DC801/DC24PartyBadge/Hardware/AccessBadge_BOM_aa.xlsx

Mfg Part # | Ref. Des. | Description Value Pkg | QTY | DNI | NOTES
CL10A475KQ5LNNC | C1, C2 | CAPACITOR, 4.7uF, C0603 | 2
GRM033R60J104KE19D | C3, C4, C5 | CAPACITOR, 0.1uF, C0201 | 3
SML-D12V1WT86 | D1 | RED, LEDCHIP-LED0603 | 1
S2B-PH-SM4-TB(LF)(SN) | J1 | JST_2MM_MALE, JST-2-SMD, Mates to single-cell LiPo batteries | 1
10118192-0001LF | JP1 | USB_MICROB_PLUGCONN-11752, USB-B-MICRO-SMD_V03, USB Micro-B Plug | 1
3220-10-0300-00 | x1 | 10 Positions Header, Shrouded Connector 0.050" (1.27mm) Surface Mount Gold | 1 |  | Digikey # 1175-1629-ND
KXT 131 LHS | SLC | TACTILE_BUTTON, KXT131 | 1
RMCF0201JT2K00 | R4 | RESISTOR, 2.0k, R0201 | 1
RMCF0201JT470R | R5 | RESISTOR, 470, R0201 | 1
RC0201FR-07105RL | R1, R11 | RESISTOR, 105, R0201 | 2
RC0201JR-0743RL | R2, R3, R12, R20 | RESISTOR, 43, R0201 | 4
RMCF0201JT1K80 | R24, R25 | RESISTOR, 1.8k, R0201 | 2
RC0201JR-0739RL | R29 | RESISTOR, 39, R0201 | 1
JS102011SAQN | S1 | SWITCH-SPDTSMD2, SWITCH-SPDT-SMD, SPDT Switch | 1
 | SPARE_1 | MA03-1, PIN HEADER | 0 | DNI
LTST-C19HE1WT | U$1, U$9 | RGB, 606 | 2 |  | Lite-On
TPS73233DBVT | U2 | Cap-Free, NMOS, 250mA Low Dropout Regulator with Reverse Current Protection, SOT-23-5, SOT95P280X145-5N | 1 |  | Texas Instruments
MCP73831T-2ACI/OT | U3 | MCP73831, SOT23-5, Microchip's MCP73831 | 1
SML-P11DTT86 | U4, U5, U11, U12, U13, U28, U29, U31, U$15, U$21 | PICO-LED, CHIP-LED0402 | 10 |  | ROHM orange LED
BMD-200-B-R | U1 | BMD-200 | 1 |  | Buying straight from might be cheapest Rigado LLC Want the rev B version
