DC801/DC24PartyBadge/Hardware/AccessBadgeV1.0.brd

## EAGLE design Hardware/AccessBadgeV1.0.brd (2016-07-16)

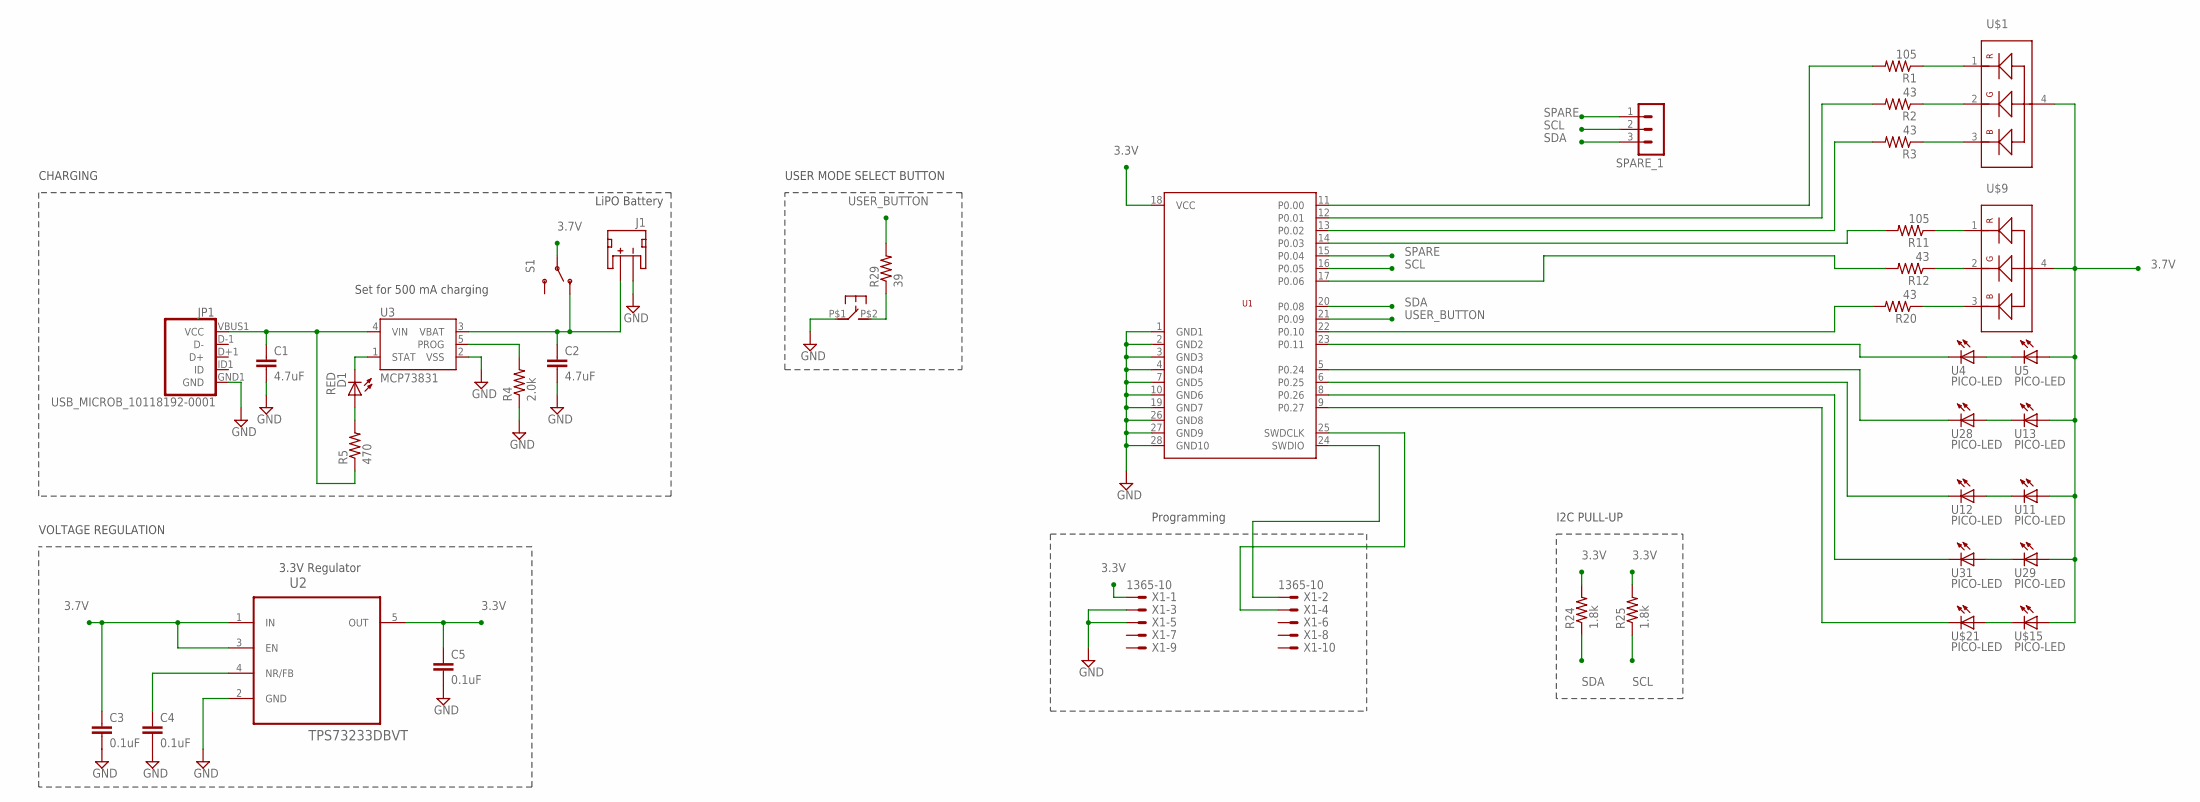
[picture p1: schematic AccessBadgeV1.0.sch]

Parts:
C1, C2: 4.7uF; 0603-CAP
C3, C4, C5: 0.1uF; C0201
D1: RED; CHIP-LED0603
J1: JST_2MM_MALE; JST-2-SMD
JP1: USB_MICROB_10118192-0001; USB-B-MICRO-SMD_V03
R1, R11: 105; R0201
R2, R3, R12, R20: 43; R0201
R4: 2.0k; R0201
R5: 470; R0201
R24, R25: 1.8k; R0201
R29: 39; R0201
S1: SWITCH-SPDTSMD2; SWITCH-SPDT-SMD
SLC: TACTILE_BUTTON; KXT131
SPARE_1: MA03-1
U1: BMD-200
U2: TPS73233DBVT; SOT95P280X145-5N
U3: MCP73831; SOT23-5
U4, U5, U11, U12, U13, U28, U29, U31: PICO-LED; CHIP-LED0402
U$1, U$9: RGB; 0606
U$15, U$21: PICO-LED; CHIP-LED0402
X1: 1365-10

Connections:
3.3V: C5.1, R24.2, R25.2, U1.18 (VCC), U2.5 (OUT), X1.1
3.7V: C3.1, S1.2, U2.1 (IN), U2.3 (EN), U5.P$1 (A), U11.P$1 (A), U13.P$1 (A), U29.P$1 (A), U$1.4, U$9.4, U$15.P$1 (A)
GND: C1.2, C2.2, C3.2, C4.2, C5.2, J1.1 (-), JP1.GND1 (GND), R4.1, SLC.P$1, U1.1 (GND1), U1.2 (GND2), U1.3 (GND3), U1.4 (GND4), U1.7 (GND5), U1.10 (GND6), U1.19 (GND7), U1.26 (GND8), U1.27 (GND9), U1.28 (GND10), U2.2 (GND), U3.2 (VSS), X1.3, X1.5
unnamed: R1.2, U1.11 (P0.00)
unnamed: R2.2, U1.12 (P0.01)
unnamed: R3.2, U1.13 (P0.02)
unnamed: R11.2, U1.14 (P0.03)
unnamed: U1.5 (P0.24), U28.P$2 (C)
unnamed: U1.9 (P0.27), U$21.P$2 (C)
unnamed: U4.P$1 (A), U5.P$2 (C)
unnamed: U1.23 (P0.11), U4.P$2 (C)
unnamed: R1.1, U$1.1
unnamed: R2.1, U$1.2
unnamed: R3.1, U$1.3
unnamed: R4.2, U3.5 (PROG)
unnamed: C1.1, JP1.VBUS1 (VCC), R5.1, U3.4 (VIN)
unnamed: D1.A, R5.2
unnamed: D1.C, U3.1 (STAT)
unnamed: R11.1, U$9.1
unnamed: R12.1, U$9.2
unnamed: C4.1, U2.4 (NR/FB)
unnamed: U$15.P$2 (C), U$21.P$1 (A)
unnamed: U29.P$2 (C), U31.P$1 (A)
unnamed: U11.P$2 (C), U12.P$1 (A)
unnamed: U13.P$2 (C), U28.P$1 (A)
unnamed: R20.1, U$9.3
unnamed: U1.8 (P0.26), U31.P$2 (C)
unnamed: U1.6 (P0.25), U12.P$2 (C)
unnamed: R20.2, U1.22 (P0.10)
unnamed: R12.2, U1.17 (P0.06)
unnamed: R29.1, SLC.P$2
unnamed: U1.24 (SWDIO), X1.2
unnamed: U1.25 (SWDCLK), X1.4
SCL: R25.1, SPARE_1.2, U1.16 (P0.05)
SDA: R24.1, SPARE_1.3, U1.20 (P0.08)
SPARE: SPARE_1.1, U1.15 (P0.04)
USER_BUTTON: R29.2, U1.21 (P0.09)
VBAT1: C2.1, J1.2 (+), S1.1 (O), U3.3 (VBAT)

Notes on the sheet:
Programming
I2C PULL-UP
LiPO Battery
Set for 500 mA charging
3.3V Regulator
USER MODE SELECT BUTTON
CHARGING
VOLTAGE REGULATION

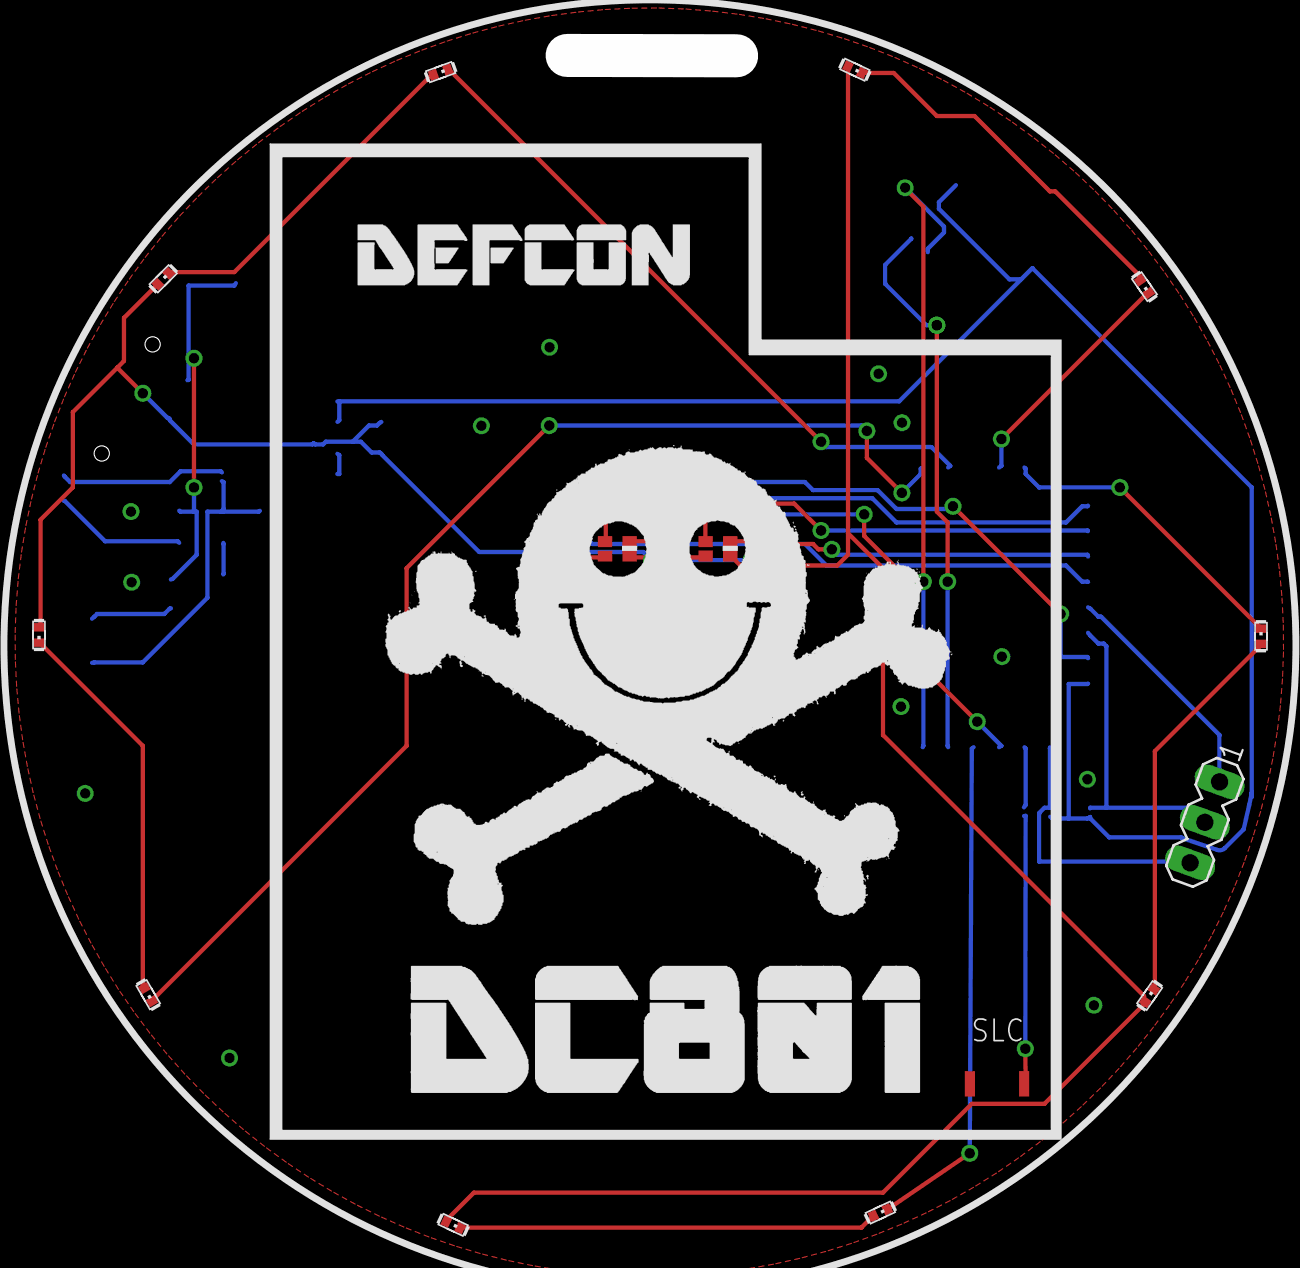
[picture p2: board AccessBadgeV1.0.brd from above]

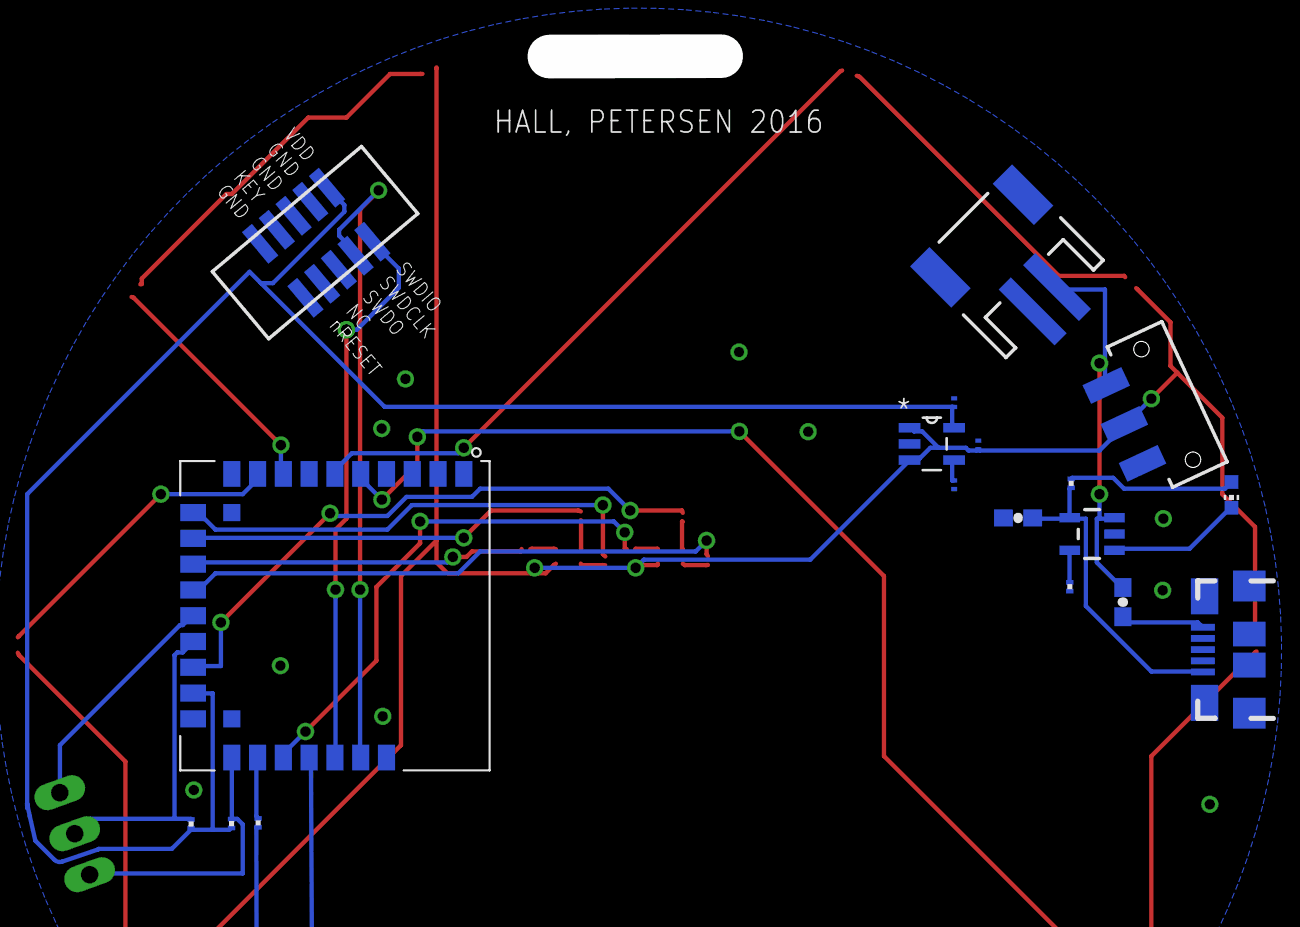
[picture p3: board AccessBadgeV1.0.brd from below]

Board: 2 copper layers, 38 parts (18 on the bottom side), 38 nets.
