DC801/DC24PartyBadge/(commit log)

2016-07-15 Base Code for board
    Base code for board
2016-07-16 new commit
    [AccessBadgeV1.0.brd, AccessBadgeV1.0.sch, AccessBadge_BOM_aa.xlsx]
2016-08-03 Adding code to monitor and react to the button being pressed Adding a few LED display modes Adding some different eddystone URLs
2016-08-03 Adding seizure mode for long press of the button
